tuppi-ovh/data-server-stm32/README.md

# Data Server on STM32

## Documentation

Refer to [docs/doc_data_server.md](docs/doc_data_server.md) file.

## License 

Refer to the [LICENSE](LICENSE) file.
