tuppi-ovh/data-server-stm32/docs/doc_data_server.md

*Last update on 25/05/2021*

# Data Server on STM32

--------------------------------------

## Introduction

The Data Server project is created to make some statisctics on internal temperature sensor (DHT22) and external temperature sensor (LaCrosse). The data from these sensors is sent to a Raspberry PI. The last one integrates a Python application which logs received data to a database. This application can also receive external commands by Telegram, for example, to update the site from the database data.

--------------------------------------

## Hardware

### Modules

```plantuml
@startuml
rectangle "BOX" as M_BOX {

    rectangle "Raspberry PI Zero\n<img:https://tuppi.ovh/data_server_stm32/images/img_doc_data_server_raspberry.png{scale=0.5}>" as M_RASP 

    rectangle "433 MHz Receiver\n<img:https://tuppi.ovh/data_server_stm32/images/img_doc_data_server_rxb6.png{scale=0.5}>" as M_433MHz

    rectangle "Connection Board" as M_CONN {
        rectangle "UART by CH340C" as M_UART 
        rectangle "3V3" as M_3V3
    }

    rectangle "STM32F100 Board\n<img:https://tuppi.ovh/data_server_stm32/images/img_doc_data_server_stm32.png{scale=0.5}>" as M_STM32

    rectangle "LED" as M_LED

    rectangle "DB9 Connector" as M_DB9
}

rectangle "DHT22 Sensor\n<img:https://tuppi.ovh/data_server_stm32/images/img_doc_data_server_dht22.png{scale=0.5}>" as M_DHT22

rectangle "ST-Link Debug" as M_DEBUG

rectangle "ISP or Flash Boot" as M_BOOT

rectangle "5V" as M_USB

M_USB --> M_RASP
M_RASP --> M_CONN
M_CONN <--> M_STM32
M_STM32 <--> M_DB9
M_STM32 --> M_LED
M_DB9 <--> M_DHT22
M_DB9 <--> M_DEBUG
M_DB9 <-- M_BOOT
M_CONN  <--> M_433MHz
@enduml
```

### 3V3

A component used to transform 5V into 3V3 is AMS1117-3.3. 

```plantuml
@startuml
rectangle "Connection Board" as M_CONN {
    rectangle "3-pin 5V Input" as M_5V
    note left
    1: Vin 
    2: GND
    3: Key
    end note
    rectangle "AMS1117-3.3 " as M_AMS
    note left
    1: Ground 
    2: Vout (with 0.1uF to GND)
    3: Vin (with 22uF to GND)
    end note
    rectangle "3V3 Output" as M_3V3
}
@enduml
```

### DB9 Connector

Pin  &nbsp; &nbsp; &nbsp; | Name  &nbsp; &nbsp; &nbsp; &nbsp; &nbsp; &nbsp; &nbsp; &nbsp; | Wire Color
------|------|------
1 | 3V3 (output) | Yellow / Red
2 | SWCLK | Yellow / Violet
3 | SWDIO | Violet 
4 | DHT_DATA | Grey
5 | BOOT0\* | Blue 
6 | N.C. | -
7 | N.C. | -
8 | N.C. | -
9 | GND | Black

*\* BOOT0: 0 – FLASH, 1 – ISP*

### LED 

The user LED is connected between 3V3 and the pin PA12 (output) via a 330 Ohm resistance. The used LED is a low cost one with working  voltage about 1V9.

### DHT22 Sensor

This sensor permits to measure the temperature and the relative humidity. 

Pin  &nbsp; &nbsp; &nbsp;| Name 
------|------
1 | 3V3
2 | DATA
3 | NC
4 | GND

It is recommended to pullup the DATA signal to 3V3 by 1k resistance. But it works also without this resistance. 

The DATA signal is input/output. So, for the simplicity, it is connected to two STM32 pins: one as STM timer input (PA15) and another to STM32 output (PA8). 

The timer is used to measure the pulse duration.

### 433 MHz Receiver

Pin  &nbsp; &nbsp; &nbsp; | Name 
------|------
1 | Antenna
2 | GND
3 | GND
4 | 3V3
5 | 3V3
6 | DER\*
7 | DATA
8 | GND

*\* DER: 1) Data output-default;  2) Battery Saving Mode*

The DATA signal is connected to STM32 input pin (PA2).

### Raspberry PI Zero

The Raspberry PI Zero has two USB ports. One is connected to the +5V power. Another is connected to CH340C for UART communication. It is important to rely pins 4 and 5 of the second USB to enable the OTG mode.

### STM32F100 Board

Pin &nbsp; &nbsp; &nbsp; | I/O &nbsp; &nbsp; &nbsp; &nbsp; &nbsp; | Description
------|------|------
PA2  | Input  | 433MHz receiver
PA8  | Output | DHT22 conversion start
PA12 | Output | LED
PA15 | Input  | DHT22 data 

The code source can be found here: [https://github.com/tuppi-ovh/data-server-stm32](https://github.com/tuppi-ovh/data-server-stm32).

### Connection Board

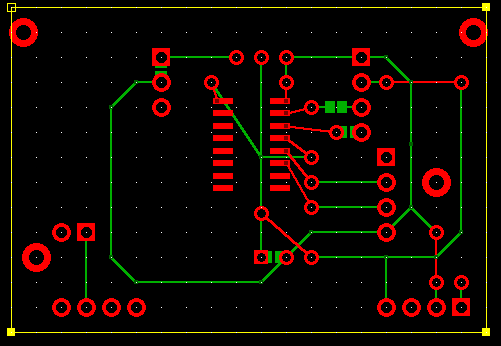
[picture p1: docs/images/img_doc_data_server_design.png]


--------------------------------------

## Firmware

### Compilation Tools 

- STM32CubeIDE

### External Code Sources

To compile the whole project you need to generate the TrueSTUDIO project from STM32CubeMX.

After that you can find some new modules inside your project folder: Drivers, TrueSTUDIO. 

You need to add some code in generated files.

**TrueSTUDIO/startup_stm32f100xb.s:**
- You need to add this line ` ldr sp, =_estack ` before this section:

```
  movs r1, #0
  b LoopCopyDataInit
```

**Src/main.c:**
- You need to insert this code into `main()` function:
```c
  extern void SERV_Init(UART_HandleTypeDef * huart, TIM_HandleTypeDef * htim);
  extern void SERV_Routine(void);
  SERV_Init(&huart1, &htim2);
  while (1)
  {
    SERV_Routine();
  }
``` 

**Src/tiny_printf.c:**
- Rightclick on the project -> New -> Other -> Library functions. And and add "Tiny printf implementation".

**Src/stm32f1xx_it.c:**
- You need to insert this code into `SysTick_Handler()` function:
```c
  extern void SERV_TickIncrement(void);
  SERV_TickIncrement();
```

### Source Code 

Source code of this project: 

- [https://github.com/tuppi-ovh/data-server-stm32](https://github.com/tuppi-ovh/data-server-stm32)

- [https://github.com/tuppi-ovh/data-server-pi](https://github.com/tuppi-ovh/data-server-pi)

--------------------------------------

## Conclusion

The board has been working good since several months. All components can be replaced by more common ones: CH340C by FTDI, STM32F100 by another STM32 board.

I put everything in two identical plastic boxes:

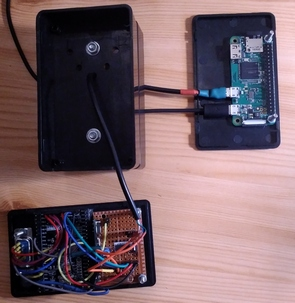
[picture p2: docs/images/img_doc_data_server_result_1.jpg]


At the end these plastic boxes were relied together:

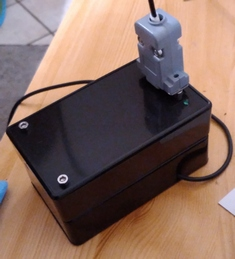
[picture p3: docs/images/img_doc_data_server_result_2.jpg]


--------------------------------------

## Interesting Links

- [DHT22 with STM32](https://www.controllerstech.com/temperature-measurement-using-dht22-in-stm32)

- [MySensors API UART](https://www.mysensors.org/download/serial_api_20)

- [LACROSSE TX141TH-BV2 Checksum Hack](https://tuppi.ovh/data_server_stm32/doc_lacrosse)
