tuppi-ovh/data-server-stm32/docs/images/img_doc_data_server_dht22.png

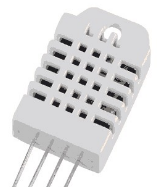
docs/images/img_doc_data_server_dht22.png
