tuppi-ovh/data-server-stm32/docs/images/img_doc_data_server_stm32.png

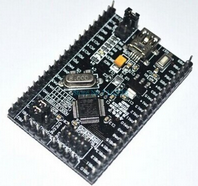
docs/images/img_doc_data_server_stm32.png
