tuppi-ovh/data-server-stm32/data-server-stm32.ioc

Mcu.UserName=STM32F100C8Tx
PA13.Signal=SYS_JTMS-SWDIO
PA12.Signal=GPIO_Output
PA9.Signal=USART1_TX
PA8.Signal=GPIO_Input
PA2.Signal=S_TIM2_CH3
PA10.Signal=USART1_RX
PA14.Signal=SYS_JTCK-SWCLK
PA15.Signal=S_TIM2_CH1_ETR
